hhh1715/flowdj---pro-mixing-interface/docs/hardware/templates/electrode-template-overlay.png

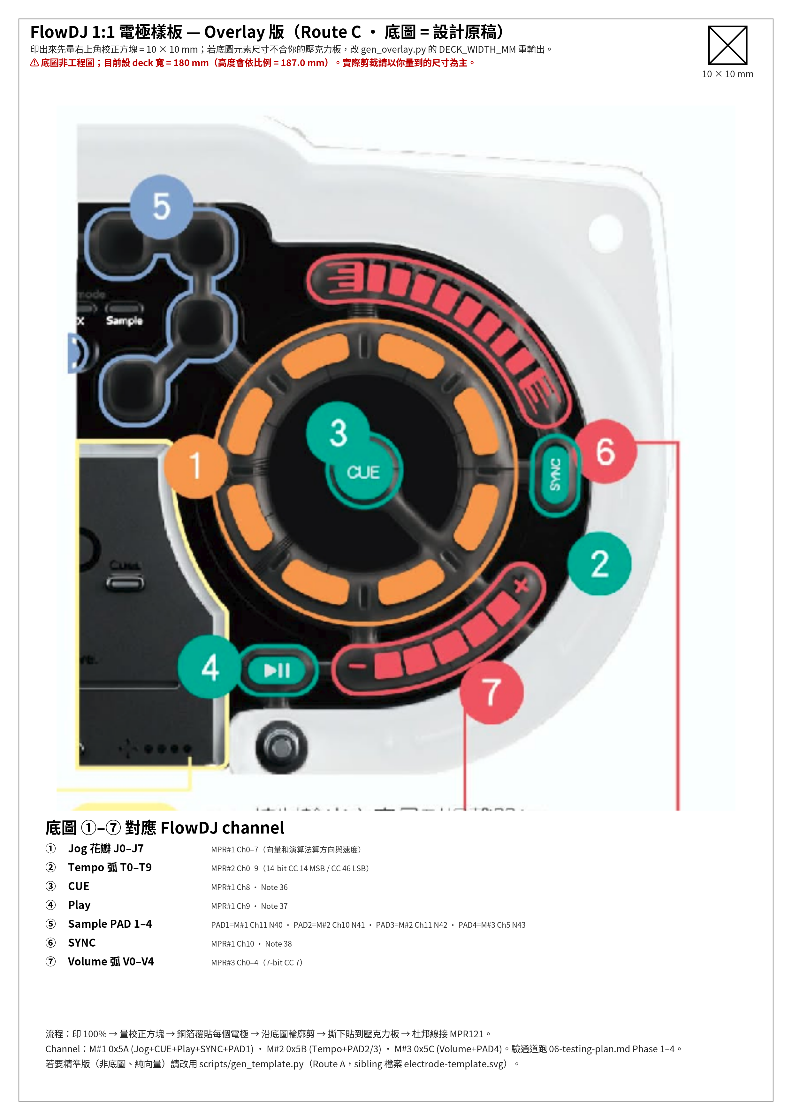
docs/hardware/templates/electrode-template-overlay.png
