hhh1715/flowdj---pro-mixing-interface/docs/superpowers/plans/2026-05-01-bpm-sync.md

# BPM Sync Implementation Plan

> **For agentic workers:** REQUIRED SUB-SKILL: Use superpowers:subagent-driven-development (recommended) or superpowers:executing-plans to implement this plan task-by-task. Steps use checkbox (`- [ ]`) syntax for tracking.

**Goal:** Make each deck's `Sync` button short-press to match the opposite deck BPM and long-press to restore that deck to its original BPM.

**Architecture:** Keep the BPM math and press-duration classification in `src/sync.js` so the behavior stays testable outside React. Wire the existing `Sync` buttons in `src/App.tsx` to pointer events for short press and long press, while preserving a keyboard-accessible click fallback.

**Tech Stack:** React 19, TypeScript/JS modules, Vite, node `assert`

---

### Task 1: Add failing tests for sync math and press classification

**Files:**
- Modify: `src/sync.test.mjs`
- Test: `src/sync.test.mjs`

- [ ] **Step 1: Write the failing tests**

```js
import assert from 'node:assert/strict';

import { getSyncPressAction, getSyncedPlaybackRate } from './sync.js';

assert.equal(
  getSyncedPlaybackRate({ sourceBpm: 128, targetBaseBpm: 100 }),
  1.28,
  'sync should derive the target playback rate from the opposite deck effective BPM',
);

assert.equal(
  getSyncedPlaybackRate({ sourceBpm: 96, targetBaseBpm: 120 }),
  0.8,
  'sync should support slowing the target deck down to match the source deck BPM',
);

assert.equal(
  getSyncedPlaybackRate({ sourceBpm: 128, targetBaseBpm: 0 }),
  null,
  'sync should ignore invalid target BPM values',
);

assert.equal(
  getSyncPressAction({ durationMs: 499 }),
  'sync',
  'releasing before the threshold should trigger bpm sync',
);

assert.equal(
  getSyncPressAction({ durationMs: 500 }),
  'restore',
  'holding at least the threshold should restore the original bpm',
);
```

- [ ] **Step 2: Run test to verify it fails**

Run: `node src/sync.test.mjs`
Expected: FAIL because `getSyncPressAction` does not exist yet

- [ ] **Step 3: Commit**

```bash
git add src/sync.test.mjs
git commit -m "test: cover sync long-press behavior"
```

### Task 2: Implement press classification helpers

**Files:**
- Modify: `src/sync.js`
- Test: `src/sync.test.mjs`

- [ ] **Step 1: Write minimal implementation**

```js
const roundRate = (value) => Number(value.toFixed(3));

export const SYNC_LONG_PRESS_MS = 500;

export const getSyncPressAction = ({
  durationMs,
  longPressThresholdMs = SYNC_LONG_PRESS_MS,
}) => (durationMs >= longPressThresholdMs ? 'restore' : 'sync');

export const getSyncedPlaybackRate = ({
  sourceBpm,
  targetBaseBpm,
}) => {
  if (
    !Number.isFinite(sourceBpm) ||
    sourceBpm <= 0 ||
    !Number.isFinite(targetBaseBpm) ||
    targetBaseBpm <= 0
  ) {
    return null;
  }

  return roundRate(sourceBpm / targetBaseBpm);
};
```

- [ ] **Step 2: Run test to verify it passes**

Run: `node src/sync.test.mjs`
Expected: PASS with no output

- [ ] **Step 3: Commit**

```bash
git add src/sync.js src/sync.test.mjs
git commit -m "feat: classify sync long press"
```

### Task 3: Wire Sync buttons for short press, long press, and keyboard fallback

**Files:**
- Modify: `src/App.tsx`
- Test: `src/sync.test.mjs`

- [ ] **Step 1: Update App sync handlers**

```ts
const syncPressTimeoutRef = useRef<{ A: number | null; B: number | null }>({ A: null, B: null });
const syncPressStartedAtRef = useRef<{ A: number; B: number }>({ A: 0, B: 0 });
const syncLongPressTriggeredRef = useRef<{ A: boolean; B: boolean }>({ A: false, B: false });
const syncSuppressClickRef = useRef<{ A: boolean; B: boolean }>({ A: false, B: false });

const restoreDeckBpm = (deck: 'A' | 'B') => {
  const track = deck === 'A' ? trackA : trackB;

  if (track == null) {
    return;
  }

  if (deck === 'A') {
    setPlaybackRateA(1);
  } else {
    setPlaybackRateB(1);
  }
};

const clearSyncPressTimeout = (deck: 'A' | 'B') => {
  const timeoutId = syncPressTimeoutRef.current[deck];

  if (timeoutId != null) {
    window.clearTimeout(timeoutId);
    syncPressTimeoutRef.current[deck] = null;
  }
};

const handleSyncPointerDown = (deck: 'A' | 'B') => {
  syncPressStartedAtRef.current[deck] = Date.now();
  syncLongPressTriggeredRef.current[deck] = false;

  syncPressTimeoutRef.current[deck] = window.setTimeout(() => {
    syncLongPressTriggeredRef.current[deck] = true;
    syncSuppressClickRef.current[deck] = true;
    restoreDeckBpm(deck);
  }, SYNC_LONG_PRESS_MS);
};

const handleSyncPointerUp = (deck: 'A' | 'B') => {
  const durationMs = Date.now() - syncPressStartedAtRef.current[deck];
  const action = getSyncPressAction({ durationMs });

  clearSyncPressTimeout(deck);
  syncSuppressClickRef.current[deck] = true;

  if (action === 'restore' || syncLongPressTriggeredRef.current[deck]) {
    syncLongPressTriggeredRef.current[deck] = false;
    return;
  }

  syncDeckToOther(deck);
};
```

- [ ] **Step 2: Run verification**

Run: `npm run lint && node src/sync.test.mjs`
Expected: TypeScript check passes and sync test passes

- [ ] **Step 3: Commit**

```bash
git add src/App.tsx src/sync.js src/sync.test.mjs docs/superpowers/plans/2026-05-01-bpm-sync.md
git commit -m "feat: add sync long-press restore"
```
