hhh1715/flowdj---pro-mixing-interface/docs/superpowers/plans/2026-05-01-mixer-eq.md

# Mixer EQ Implementation Plan

> **For agentic workers:** REQUIRED SUB-SKILL: Use superpowers:subagent-driven-development (recommended) or superpowers:executing-plans to implement this plan task-by-task. Steps use checkbox (`- [ ]`) syntax for tracking.

**Goal:** Make each deck's `Hi`, `Mid`, and `Low` knobs control a real three-band EQ on the playing track audio.

**Architecture:** Add a small pure helper for knob-to-dB mapping, plus a focused Web Audio helper that creates one EQ chain per deck. Update `src/App.tsx` to route each hidden `<audio>` element through that chain, keep crossfader/level control on the output gain node, and update filter gains whenever mixer knob state changes.

**Tech Stack:** React 19, TypeScript/JS modules, Vite, Web Audio API, node `assert`

---

### Task 1: Add failing tests for EQ knob mapping

**Files:**
- Create: `src/eq.js`
- Create: `src/eq.test.mjs`
- Test: `src/eq.test.mjs`

- [ ] **Step 1: Write the failing test**

```js
import assert from 'node:assert/strict';

import { getEqGainDbFromKnobValue } from './eq.js';

assert.equal(
  getEqGainDbFromKnobValue(50),
  0,
  '50 should be the neutral EQ position',
);

assert.ok(
  getEqGainDbFromKnobValue(0) < 0,
  'values below neutral should attenuate the band',
);

assert.ok(
  getEqGainDbFromKnobValue(100) > 0,
  'values above neutral should boost the band',
);

assert.equal(
  getEqGainDbFromKnobValue(-20),
  getEqGainDbFromKnobValue(0),
  'mapping should clamp low out-of-range values',
);

assert.equal(
  getEqGainDbFromKnobValue(120),
  getEqGainDbFromKnobValue(100),
  'mapping should clamp high out-of-range values',
);
```

- [ ] **Step 2: Run test to verify it fails**

Run: `node src/eq.test.mjs`
Expected: FAIL because `src/eq.js` does not exist yet

- [ ] **Step 3: Commit**

```bash
git add src/eq.test.mjs
git commit -m "test: cover mixer eq mapping"
```

### Task 2: Implement EQ mapping and audio-chain helpers

**Files:**
- Create: `src/eq.js`
- Modify: `src/mixer.js`
- Test: `src/eq.test.mjs`

- [ ] **Step 1: Write minimal implementation**

```js
const clampKnob = (value) => Math.min(Math.max(Number.isFinite(value) ? value : 50, 0), 100);

export const getEqGainDbFromKnobValue = (value, maxGainDb = 18) => {
  const normalized = (clampKnob(value) - 50) / 50;
  return Number((normalized * maxGainDb).toFixed(3));
};
```

- [ ] **Step 2: Run test to verify it passes**

Run: `node src/eq.test.mjs`
Expected: PASS with no output

- [ ] **Step 3: Commit**

```bash
git add src/eq.js src/eq.test.mjs
git commit -m "feat: add mixer eq helpers"
```

### Task 3: Route deck audio through Web Audio EQ chains

**Files:**
- Modify: `src/App.tsx`
- Test: `src/eq.test.mjs`

- [ ] **Step 1: Add per-deck audio graph setup and output gain routing**

```ts
const audioContextRef = useRef<AudioContext | null>(null);
const deckAudioGraphRef = useRef({
  A: null,
  B: null,
});
```

- [ ] **Step 2: Keep crossfader and level control on graph output gain and update EQ gains from knob state**

```ts
const gains = getDeckMixGains({
  crossfader,
  levelA: deckVolumesA.track,
  levelB: deckVolumesB.track,
});

deckAudioGraphRef.current.A?.outputGain.gain.setTargetAtTime(gains.deckA, context.currentTime, 0.01);
deckAudioGraphRef.current.B?.outputGain.gain.setTargetAtTime(gains.deckB, context.currentTime, 0.01);
```

- [ ] **Step 3: Run verification**

Run: `npm run lint && node src/eq.test.mjs && node src/levelControl.test.mjs && node src/sync.test.mjs`
Expected: TypeScript check passes and all three test files pass

- [ ] **Step 4: Commit**

```bash
git add src/App.tsx src/eq.js src/eq.test.mjs docs/superpowers/plans/2026-05-01-mixer-eq.md
git commit -m "feat: wire mixer eq audio chain"
```
