hhh1715/flowdj---pro-mixing-interface/design/DJ_controller導電墨水圖.jpeg

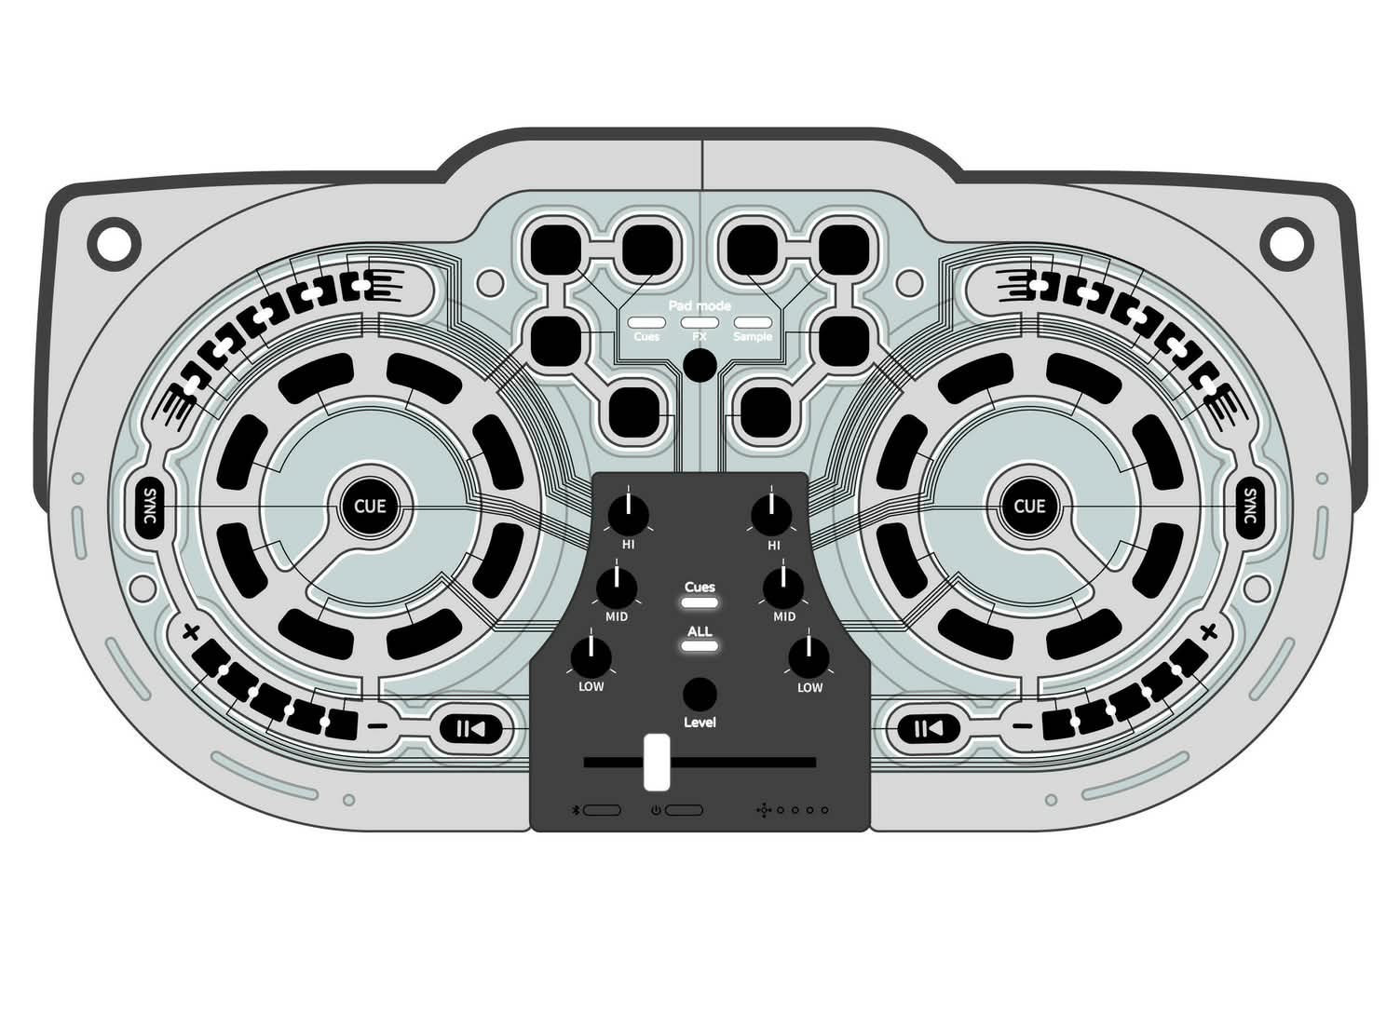
design/DJ_controller導電墨水圖.jpeg
