hhh1715/flowdj---pro-mixing-interface/design/UI目前畫面.png

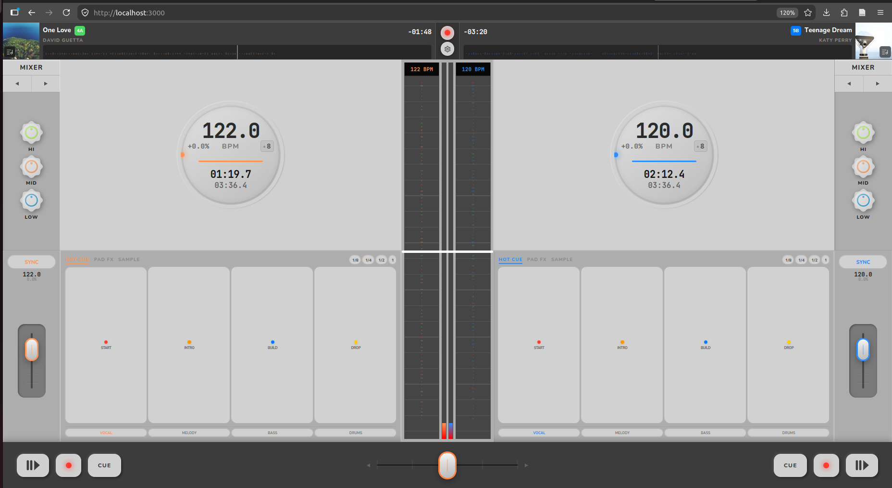
design/UI目前畫面.png
