hhh1715/flowdj---pro-mixing-interface/design/四審展版-05.jpg

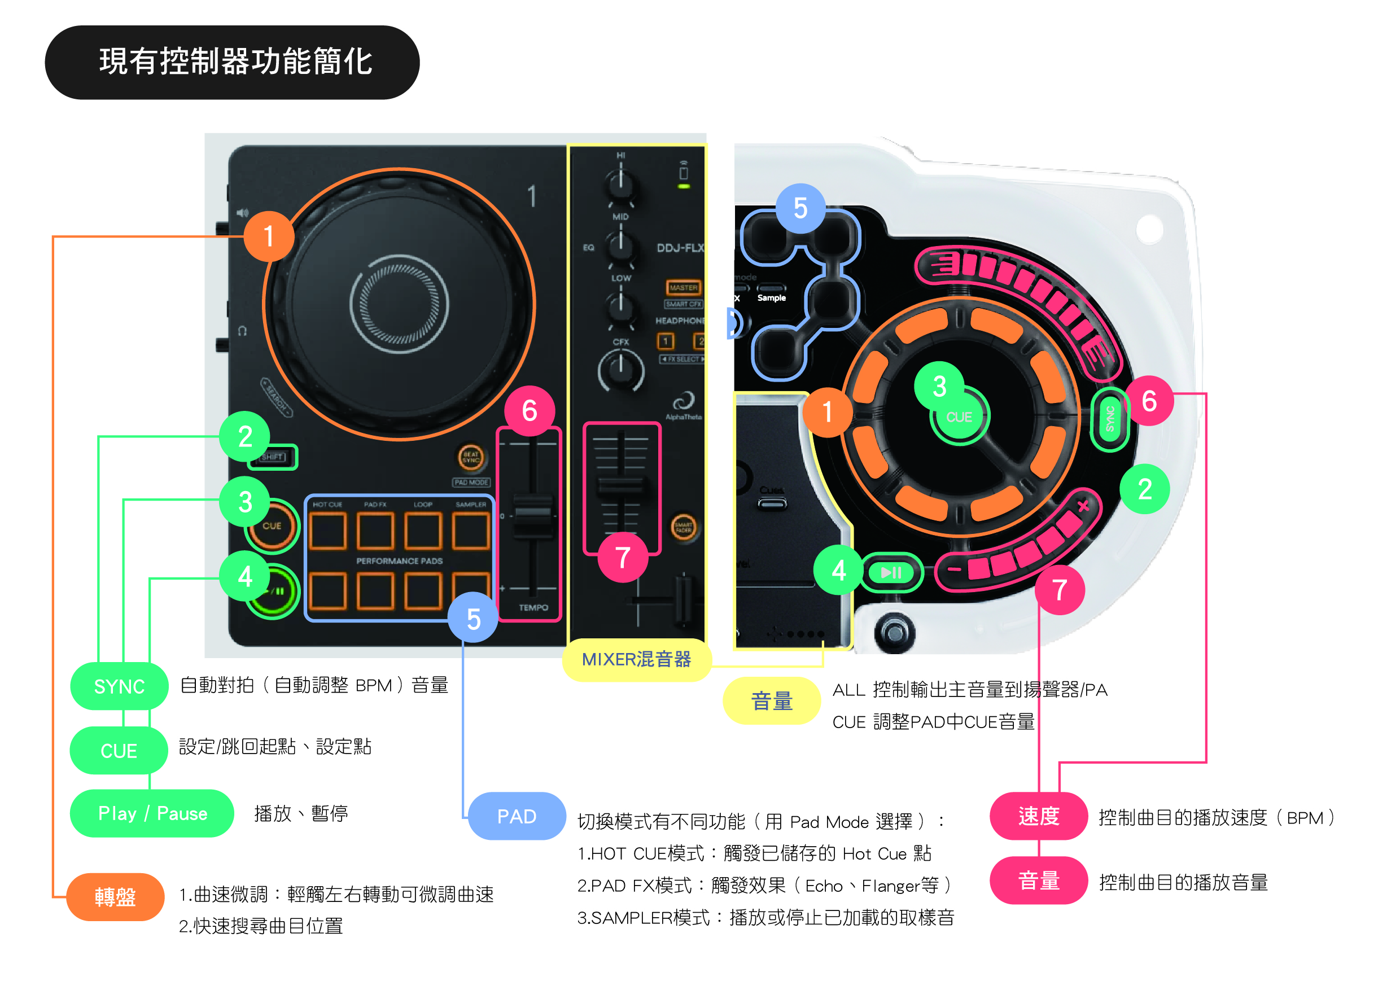
design/四審展版-05.jpg
