hhh1715/flowdj---pro-mixing-interface/design/要完成功能部份.png

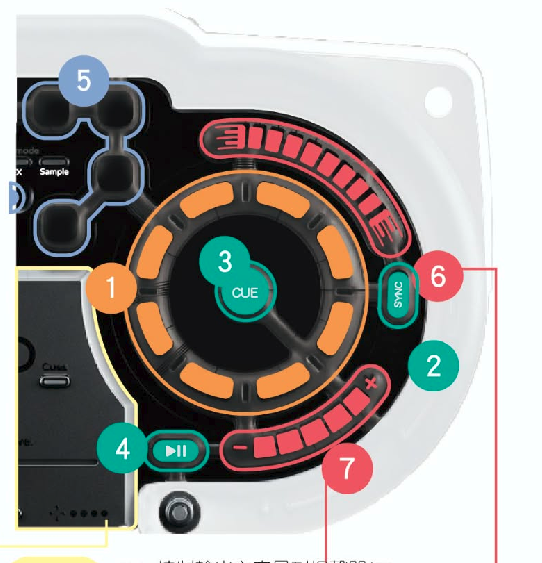
design/要完成功能部份.png
