hhh1715/flowdj---pro-mixing-interface/docs/hardware/images/mpr121-pinout-black-generic.jpg

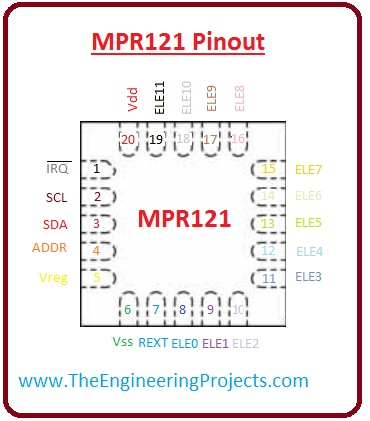
docs/hardware/images/mpr121-pinout-black-generic.jpg
