hhh1715/flowdj---pro-mixing-interface/docs/hardware/images/mpr121-pinout-original.jpg

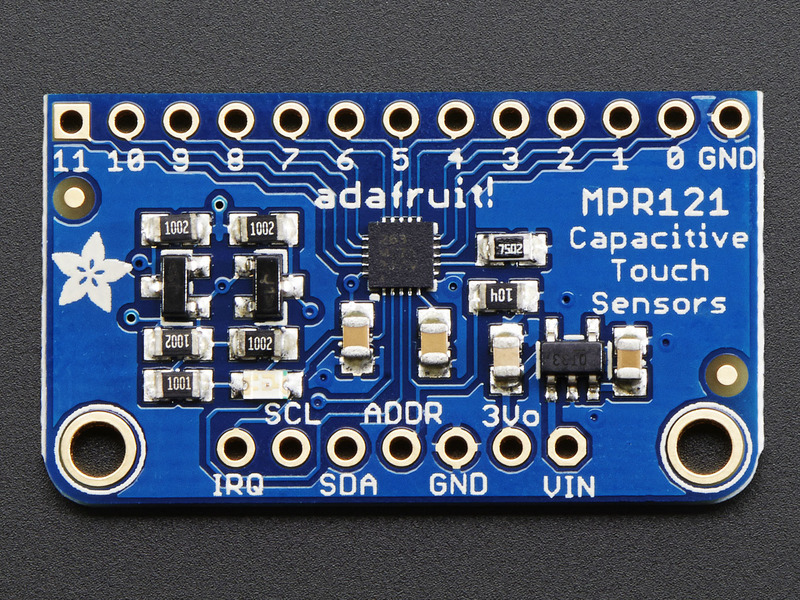
docs/hardware/images/mpr121-pinout-original.jpg
