hhh1715/flowdj---pro-mixing-interface/docs/hardware/templates/electrode-template.png

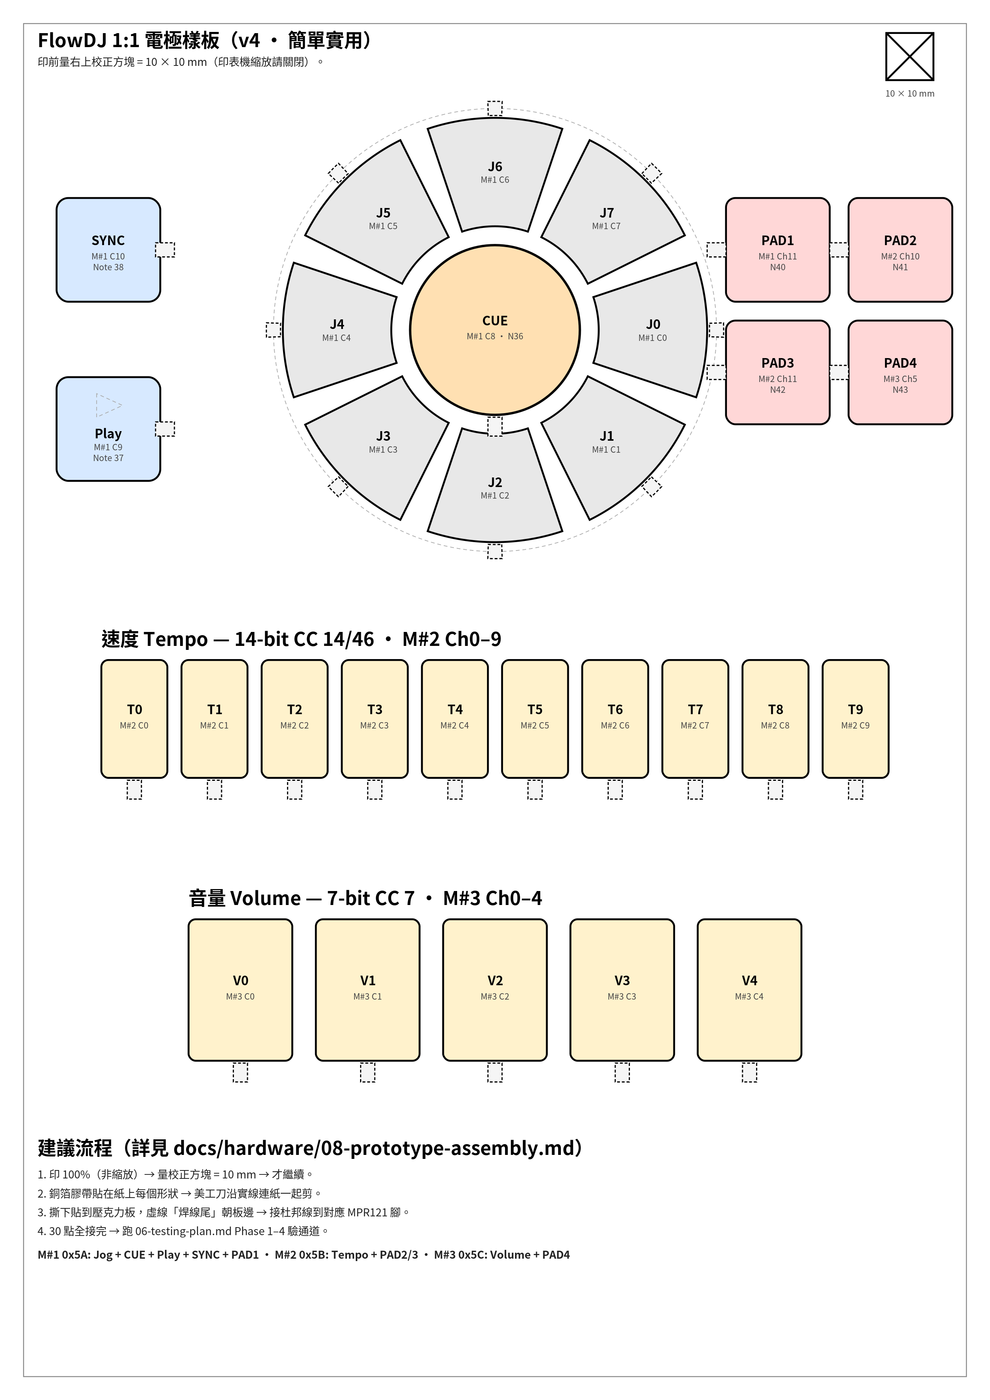
docs/hardware/templates/electrode-template.png
