hhh1715/flowdj---pro-mixing-interface/(commit log)

2026-04-19 docs(hardware): add Teensy + MPR121 controller manual
    Add docs/hardware/ with 8 markdown files and 5 pinout images covering
    glossary, pinouts, wiring, MIDI protocol, centroid algorithm and a
    six-phase testing plan using copper tape as the intermediate electrode
    material before final conductive ink build.
2026-04-19 docs(hardware): add wiring SVG diagram and Fritzing guide
    - images/wiring-diagram.svg: schematic-style diagram showing the Teensy
    3.3V/GND rails, SDA/SCL I²C bus, and ADD-pin address-select paths for
    all three MPR121 modules across the EIC-104 breadboard zones.
    - 07-fritzing-guide.md: step-by-step procedure to reproduce the same
    wiring as a breadboard-view Fritzing sketch, for users who prefer the
    Fritzing visual style.
2026-04-19 docs(hardware): 4-agent review — fix critical errors + expand manuals
    Reviewed all 9 manuals via 4 parallel agents cross-checking against
    PJRC, NXP, Adafruit, MIDI.org, caniuse, and library source.
    P0 fixes (hardware-damaging or build-blocking):
    - 01: Teensy 4.0 is Micro-B USB, not USB-C (wrong cable warning)
    - 01: replace inaccurate ASCII pinout with official PJRC PDF refs
    - 05/06: remove incorrect `baselineData() << 2` shift — Adafruit
    library already shifts internally; extra shift makes delta garbage
    - 07: remove dead Fritzing repo URLs (bloomlive/fritzing-teensy 404,
    MCUdude is ATmega not Teensy); point to Adafruit Fritzing-Library
    and PJRC forum instead
    - 03: resolve Adafruit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
2026-04-19 docs(hardware): sweep cleanup — pin位置、ADDR 殘留、USB-C 殘留、TI SLVA689 引用
    - 01: 修正 ASCII 圖與說明文 (3.3V 是右排第 3 pin, 非最頂；最頂是 Vin)
    - 00/07/SVG: 殘留 USB-C / ADDR 全數統一為 Micro-B / ADD（保留對比說明段落）
    - 02: 電氣規格表註明「黑板 3.3V 限定；Adafruit 才有 regulator 吃 3–5V」
    - 03: TI AN-10216 → TI SLVA689（URL 本就是 SLVA689，引用名稱對齊）
2026-04-19 feat(firmware): scaffold Phase 1–4 Arduino sketches
    四支 .ino 與手冊 06-testing-plan.md 對應：
    - 01_i2c_scan: I²C bus 掃描
    - 02_mpr121_raw: 3 顆 MPR121 touch state
    - 03_midi_out: USB MIDI Note On/Off
    - 04_algorithms: slider centroid + jog vector sum
    尚未做 arduino-cli 編譯驗證（機器未安裝，等使用者決定是否安裝）。
2026-04-19 feat(hardware): add Web MIDI layer + smoke-test monitor
    - src/hardware/webmidi.ts: parseMidiMessage、FlowDjMidiMapper、initMidi、useMidi hook
    - src/hardware/MidiMonitor.tsx: fixed 右下角 panel，列出狀態 / 輸入裝置 / 最近事件
    - App.tsx: 掛上 <MidiMonitor /> 當 smoke test overlay
    對應 04-midi-protocol.md 訊息表：CUE/Play/SYNC/PAD1-4/JogTouch notes、
    CC 7 volume、CC 14+46 14-bit tempo、CC 16 signed jog delta。
    tsc --noEmit 通過；vite dev server 正常啟動回 HTTP 200。
2026-04-19 build(firmware): arduino-cli 驗證 4 支 sketch 全數編過
    - firmware/build.sh: 一鍵編譯 4 支，帶正確 FQBN (usb=serialmidi)
    - firmware/README.md: 補 arduino-cli 安裝步驟 + usb=serialmidi 說明
    （不帶此參數 03/04 會報 "'usbMIDI' was not declared"）
    - 手冊版本鎖: Adafruit_MPR121 1.1.3 → 1.2.1（1.1.3+ 皆可）
    驗證環境：arduino-cli 1.4.1, teensy:avr 1.60.0, Adafruit MPR121 1.2.1
2026-04-19 docs(hardware): add prototype assembly manual + printable electrode template
    把銅箔膠帶 + 壓克力原型化做法完整文件化：
    - 08-prototype-assembly.md：紙印樣板 → 銅箔貼紙 → 沿線剪 → 連紙撕 → 貼壓克力
    的完整流程，涵蓋 Jog 8 弧、slider 10 片、fader 5 片、4 PAD、3 按鈕共 30 個電極。
    含焊線尾處理、疊壓/焊接兩種接線法、分色/標籤、萬用電表驗收清單。
    - templates/electrode-template.svg：A4 直向 1:1 列印樣板，mm 精度。含 10×10 mm
    校正方塊（量它確認印表機沒縮放）、每個電極 MPR#x Ch y 標註、Jog 中心
    「空心不貼」提示、焊線尾指示、圖例與流程備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
2026-04-19 docs(deployment): add non-engineer-friendly setup manual
    寫給設計系同學的部署手冊：從完全沒寫過程式的角度，
    帶著走完 Mac/Windows 上的 Node.js/git 安裝、clone 專案、
    申請 Gemini API 金鑰、npm install/dev、接 Teensy、Web MIDI 授權
    的完整流程，含疑難排解與名詞中文對照。
    （既有 SETUP.md 留給有開發經驗的使用者；這份放在 docs/deployment/
    做為「零經驗版」。）
2026-04-19 docs: cross-link SETUP.md to beginner deployment manual
    SETUP.md 假設讀者懂 Node/npm/git；設計系同學應該看 docs/deployment。
    在 SETUP.md 頂部加一段導引讓兩邊使用者走對方向。
2026-04-19 feat(hardware): mock mode + UI integration playbook
    針對「未來 UI 會被整個換掉、但換完後要能快速把 MIDI 接回去」這個情境做準備，
    全部改動都在非 JSX 檔，瀏覽器畫面零變動：
    - webmidi.ts：useMidi({ mock: true }) 選項跳過 navigator.requestMIDIAccess()，
    回傳多一個 emit() 讓整合測試時手動注入事件。正常模式預設行為完全不變，
    emit() 在非 mock 時為 no-op。
    - 09-ui-integration.md：寫給「收到新 UI 後要整合 MIDI 的未來自己」的 checklist，
    含事件對應表、最小接法 snippet、mock mode 用法、5 個常見踩坑。
    tsc --noEmit 通過；既有 MidiMonitor.tsx 無需改動。
    Co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
2026-04-19 test: add vitest suite + firmware Phase 5 full integration sketch
    B. Unit tests (`src/hardware/webmidi.test.ts`)：
    - parseMidiMessage: Note On/Off 慣例、CC、channel nibble、unknown status、短 packet
    - FlowDjMidiMapper: 所有按鈕 Note、volume、14-bit tempo MSB+LSB 合併、
    jog signed 7-bit delta 正反方向 + 極值
    - 共 24 tests，全過
    - package.json 加 `npm test` / `npm run test:watch`，devDep: vitest/coverage/happy-dom
    C. Phase 5 完整韌體（`firmware/tests/05_full_integration/`）：
    - 3 顆 MPR121 (0x5A/0x5B/0x5C) × 30 電極 → 完整 MIDI 協議
    - 通道配置對齊 electrode-template.svg
    - 100 Hz 掃描；邊緣觸發按鈕；deadband 過濾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
2026-04-19 docs(hardware): redesign electrode template with concentric Jog+Tempo and PNG export
    Switches the 1:1 copper-tape template from a utilitarian grid to a layout
    that matches the design student's conductive-ink reference:
    - Jog as central green CUE disc ringed by 8 annular-sector lobes (J0-J7)
    with 8° gaps between wedges, giving a clear cut line per electrode
    - Tempo slider is now a concentric arc to the right of the Jog (10
    wedges, 100° span), instead of a linear row
    - SYNC / Play become capsule buttons to the left of the Jog
    - PAD1-4 compacted into one horizontal row; volume fader stays linear
    but centered at the page bottom
    scripts/gen_template.py generates both the S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
2026-04-19 docs(hardware): rebuild template toward reference design + add overlay variant
    Route A — rewrite scripts/gen_template.py to match the design student's
    deck-layout-target.png aesthetic while keeping the 30-electrode demo scope:
    - Jog lobes are now petal-shaped (stadium bent along an arc) with 7°
    gaps between petals — not plain annular sectors
    - Volume moves from a linear fader to a concentric arc (5 wedges, lower
    right), mirroring the reference's curved slider
    - Tempo gap widens from 1° to 2.5° (≈2.7 mm @ r=62) so manual scissors
    can separate the wedges
    - PAD1–4 regrouped into a 2×2 grid at top-left, matching the reference
    Sample-pad block
    - Play becomes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
2026-04-19 docs(hardware): simplify Route A template to rectilinear cut-friendly shapes
    The v3 petal-lobe + dual concentric arc layout looked close to the
    reference mockup but traded away cutability. User feedback: prefer a
    simpler practical version.
    v4 reverts the expressive flourishes — keeps only shapes a classmate can
    cut with a utility knife along straight lines and one wide annular ring:
    - Jog back to 8 plain annular sectors (8° gap, no stadium petals)
    - Tempo back to a horizontal row of 10 rectangles (no concentric arc)
    - Volume back to a horizontal row of 5 rectangles (no concentric arc)
    - SYNC / Play become rounded squares on the left, PAD1-4 a 2x2 grid on
    the right — both f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
2026-04-28 merge upstream UI updates (knob/crossfader/deckDisplay + pad mode)
    Synced from upstream guiguiiii/flowdj---pro-mixing-interface to bring in:
    - new pure-JS modules: crossfader.js, deckDisplay.js, knob.js (with node:test specs)
    - App.tsx UI updates: pad mode switching, hot cue restyle, knob redesign,
    smooth deck orbit motion, smooth knob rotation, level fader pads
    - vite.config.ts: exclude *.test.mjs from vitest (upstream uses node:test, not vitest)
    Local hardware integration preserved: MidiMonitor import + render kept in App.tsx.
2026-04-28 docs(design): import design references
    Migrated from outer DJ-Controller repo into a single source of truth:
    - DJ_controller導電墨水圖.jpeg — conductive ink layout
    - UI目前畫面.png — current UI screenshot
    - 四審展版-05.jpg — exhibition board (4th review)
    - 控制器功能.jpeg — controller function reference
    - 要完成功能部份.png — outstanding feature checklist
2026-05-06 Build hardware MIDI controller firmware (Phase 2–5)
    Iterates the four-phase test plan into a working Teensy 4.0 + 3×MPR121
    firmware that drives the FlowDJ UI over USB MIDI:
    - 02 raw read: software-tracked baseline (chip's internal tracker
    underperforms on conductive ink) with hysteresis touch detection.
    - 03 MIDI out: Note 36/37/38 for CUE/Play/SYNC.
    - 04 algorithms: 1D centroid for slider/fader, 2D vector sum for jog.
    - 05 full integration: the production firmware. CC 7 (volume), CC 14/46
    (14-bit tempo), CC 16 (signed jog delta with fractional residual
    accumulator so slow rotation isn't truncated). Direction flipped so
    CW = forward to match DJ convention. Per-pad touch gating pr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
    [02_mpr121_raw.ino, 03_midi_out.ino, 04_algorithms.ino, 05_full_integration.ino]
2026-05-06 Wire hardware MIDI input into Deck A controls
    Connects the Teensy firmware to the React UI:
    - Buttons: Note 36/37/38 → CUE / Play / SYNC; 40–43 → PAD 1–4
    (mode-aware: hot cue / sample / pad FX). 200 ms per-button debounce
    to absorb hardware bouncing. Hardware CUE has fall-through (assign
    if unset, else recall) so the first press isn't a noop.
    - Knobs: CC 7 → volume fader, CC 14/46 → 14-bit tempo, CC 16 →
    jog scratch with RAF-batched seek (writing audio.currentTime at
    100 Hz glitches the audio buffer; batching to 60 Hz fixes it).
    Tuned scrub ratio 0.018 + 2° min accumulation.
    - MidiMonitor split into two components sharing state via localStorage
    + custom event: a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
2026-05-06 Add Crowd Lu — 早安，晨之美！ to library
2026-05-06 Add hardware deck switcher (A ⇄ B)
    The MIDI dispatch path was hardcoded to Deck A. Replace the literal
    'A' with a hardwareDeckRef read at dispatch time, and pull both decks'
    state (level control / pad mode / sample bank / pad-fx bank) into the
    handlers ref so either deck can be the target.
    Footer gains a small "HW → A/B" pill next to the MIDI Monitor toggle:
    click toggles, color follows deck (orange / blue), choice persists
    to localStorage. Switching mid-touch ends the previous deck's jog so
    scratch state doesn't leak across decks.
2026-05-06 Reject volume fader noise-floor false touches
    A pad whose baseline drifts up by ~3 (just above TOUCH_DELTA) sticks
    in the 'touched' state and never recovers, since baseline EMA only
    runs while not touched. Combined with sub-NOISE_THR weight leaking in
    from neighbour pads, the centroid oscillates in a small range and
    floods CC 7 events.
    Add a per-fader minimum-wsum gate (VOL_TOUCH_WSUM_MIN = 6) before
    treating volTouch as real. Genuine finger contact gives wsum >= 6;
    single-pad noise ghosts sit at 3-5 and now get filtered.
    [05_full_integration.ino]
2026-05-06 Generalize wsum gate to tempo and jog
    Volume's noise-floor patch wasn't enough — on machines with noisier
    USB power / different ground reference, the same baseline-drift ghost
    hits the tempo slider and jog wheel too.
    Apply the same per-control wsum minimum:
    - VOL_TOUCH_WSUM_MIN = 8 (5 pads, finger covers 2-3)
    - TEMPO_TOUCH_WSUM_MIN = 8 (10 pads)
    - JOG_TOUCH_WSUM_MIN = 5 (8 pads, finger usually on 1-2)
    Real finger contact gives wsum well above these. Single-pad ghosts
    sit at 3-5 and now get filtered uniformly.
    [05_full_integration.ino]
2026-05-06 Match HW / MIDI toggle buttons to CUE/Play size
    The footer pills used inline styles with their own padding and font
    size, looking out of place next to the neumorphic transport buttons.
    Both now use the existing transport-secondary class (h-10, px-4,
    rounded-xl, 10px tracking-widest text). HW gets a deck-tinted bg
    (orange/blue) matching the CUE-active visual language.
2026-05-06 Raise noise floor thresholds for noisier USB environments
    The wsum gate alone wasn't enough on machines where every pad sees
    delta 2-3 from environmental noise (Windows desktop with grounded
    PSU vs. laptop on battery): multiple noisy pads sum past the gate
    and feed centroid garbage.
    Bump:
    - TOUCH_DELTA 3 → 4 (touch entry threshold; noise spikes of 2-3 no
    longer flip pads into 'touched')
    - NOISE_THR 1 → 3 (per-pad weight ignores delta ≤ 3, so faint
    background noise contributes 0 to centroid)
    Real finger contact gives delta 5-15+, both still pass comfortably.
    On low-noise machines (Ubuntu laptop on battery), the previous 3/1
    worked fi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
    [05_full_integration.ino]
2026-05-06 Restore touch sensitivity, absorb noise via deadband
    The previous TOUCH_DELTA/NOISE_THR bump killed real touches too —
    the noise/touch delta gap is too narrow to draw a clean line by
    threshold alone.
    Different strategy: keep low touch thresholds so real touches still
    register, but raise the per-CC output deadband. Even if a ghost
    crosses the touch threshold and the centroid produces a position,
    its small fluctuation (typically a few units) won't exceed the
    deadband, so the CC simply isn't emitted.
    - TOUCH_DELTA back to 3 (real touches register)
    - NOISE_THR back to 1
    - VOLUME_DEADBAND 1 → 8 (~6.3% of 7-bit range)
    - TEMPO_DEADBAND 8 → 64 (~0.4% of 14-bit range)
    A real fader mo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
    [05_full_integration.ino]
2026-05-06 Revert to original (Ubuntu-tested) noise settings to test USB hub
    The deploy partner is now connecting the controller through a powered
    USB-C hub instead of directly into a Windows desktop. The hub may
    isolate enough USB power / ground noise that the original loose
    thresholds (which work cleanly on the Ubuntu laptop) are sufficient.
    Roll back the Windows-noise mitigations:
    - VOLUME_DEADBAND 8 → 1
    - TEMPO_DEADBAND 64 → 8
    - VOL/TEMPO/JOG_TOUCH_WSUM_MIN gates: removed
    Keep the jog fractional residual accumulator and the CW=forward
    direction flip — those are unrelated to noise.
    If the hub fixes it cleanly, this is the final state. If noise
    returns, re-introduce the wsum gates / deadb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
    [05_full_integration.ino]
